RaghavS06/hft_fpga_engine/images/image.png

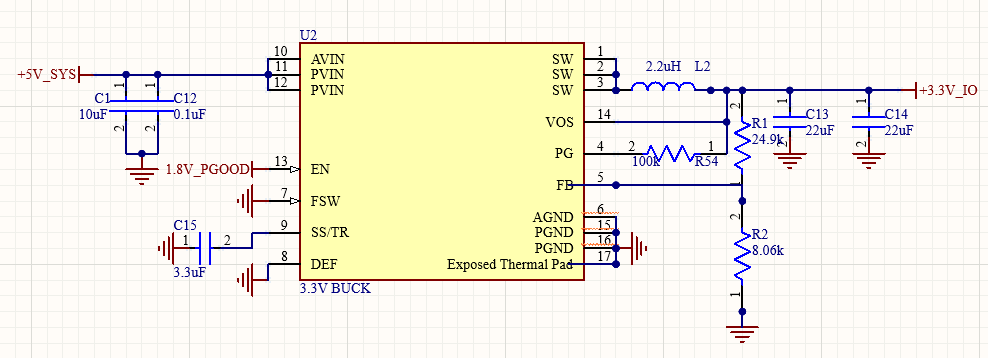
images/image.png
