RaghavS06/hft_fpga_engine/images/Screenshot 2026-09-29 161727.png

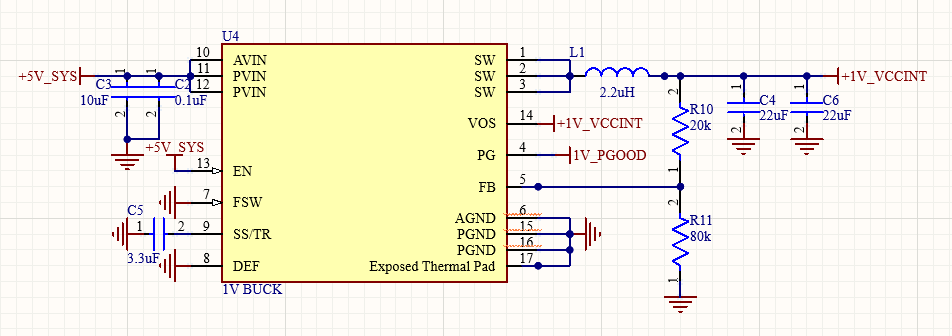
images/Screenshot 2026-09-29 161727.png
