RaghavS06/hft_fpga_engine/images/Screenshot 2026-09-29 161811.png

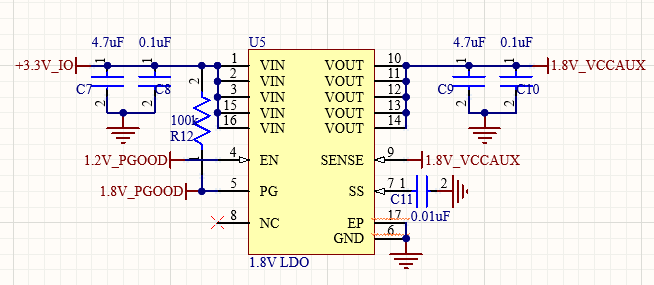
images/Screenshot 2026-09-29 161811.png
