RaghavS06/hft_fpga_engine/(commit log)

2026-07-12 Revise README.md for HFT FPGA Trading Engine
    Updated project description and details in README.md to provide a comprehensive overview of the HFT FPGA Trading Engine, including architecture, PCB design, packet parsing, clock domain crossing, and lessons learned.
2026-09-29 Enhance README with power tree and images
    Added images and detailed power tree information to the README.
